LandryEllis/ENCE_3231/2WheelBotFinal5-5/components/ESP8266-01_ESP-01/step/ESP8266-01_ESP-01.step

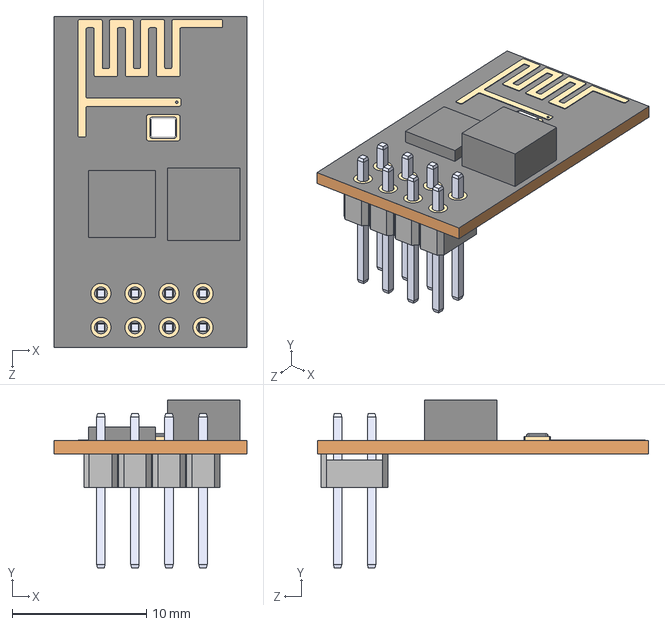
[picture p12: CAD file, 2026-04-23]
2WheelBotFinal5-5/components/ESP8266-01_ESP-01/step/ESP8266-01_ESP-01.step
14.4 x 12.5 x 24.7 mm
