LandryEllis/ENCE_3231/2WheelBotFinal5-5/components/Fuse_3DModel/MF-MSMF050-2--3DModel-STEP-56544.STEP

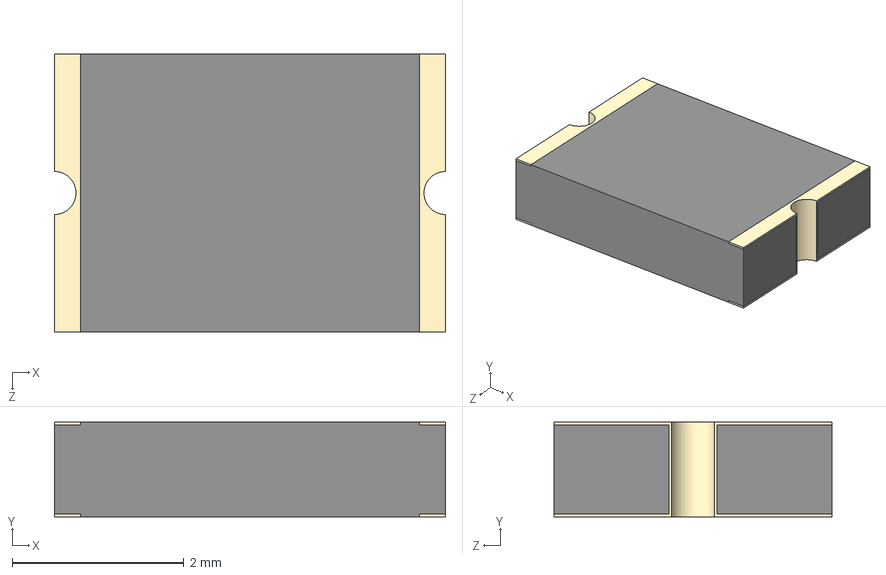
[picture p13: CAD file, 2026-04-23]
2WheelBotFinal5-5/components/Fuse_3DModel/MF-MSMF050-2--3DModel-STEP-56544.STEP
4.55 x 1.10 x 3.24 mm
