LandryEllis/ENCE_3231/2WheelBotFinal5-5/components/MPU6050/ITG-MPU.STEP

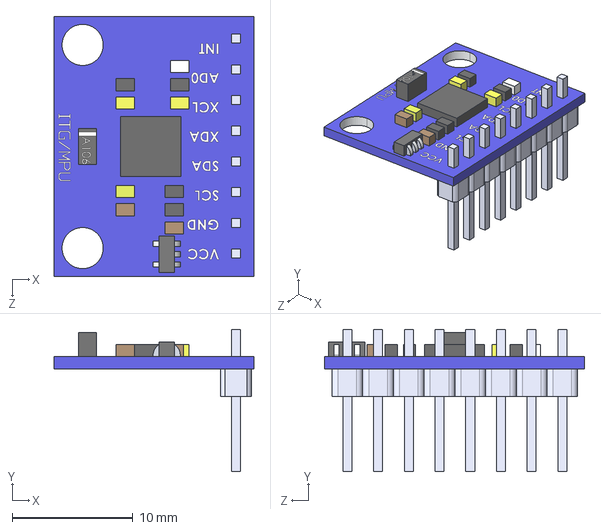
[picture p14: CAD file, 2026-04-23]
2WheelBotFinal5-5/components/MPU6050/ITG-MPU.STEP
16.5 x 11.8 x 21.5 mm
8 Header-Pin
Placa_Base
