LandryEllis/ENCE_3231/2WheelBotFinal5-5/components/SPDT_Slide_Switch/step/SLW-66527511-SMT-TR.step

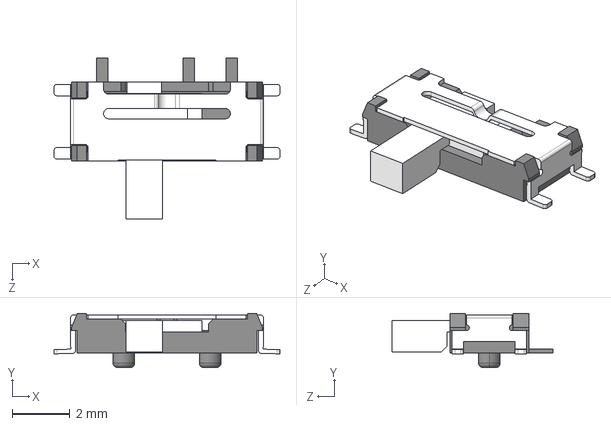
[picture p15: CAD file, 2026-04-23]
2WheelBotFinal5-5/components/SPDT_Slide_Switch/step/SLW-66527511-SMT-TR.step
7.86 x 1.88 x 5.58 mm
