LandryEllis/ENCE_3231/2WheelBotFinal5-5/components/SW_uP_Reset/step/SW_uP_Reset.stp

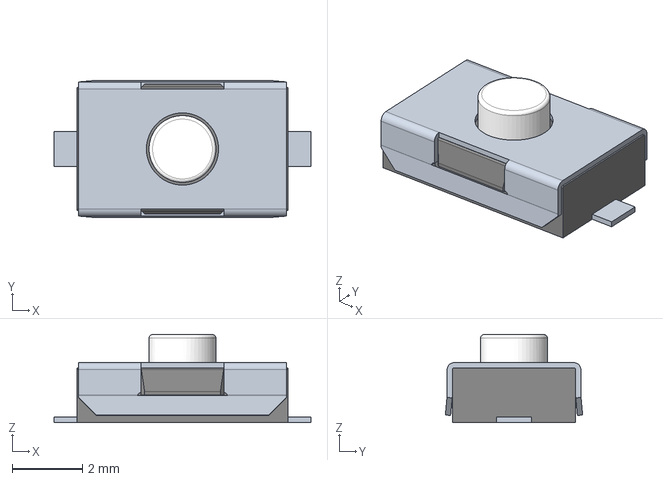
[picture p16: CAD file, 2026-04-23]
2WheelBotFinal5-5/components/SW_uP_Reset/step/SW_uP_Reset.stp
7.30 x 3.90 x 2.50 mm
