LandryEllis/ENCE_3231/2WheelBotFinal5-5/components/USB4105GFA--3DModel-STEP-510211.STEP

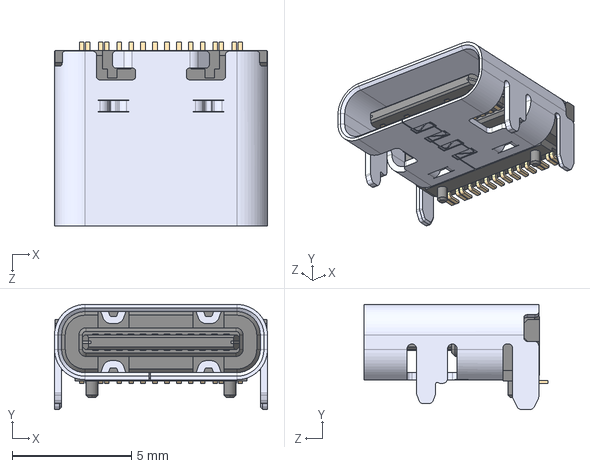
[picture p17: CAD file, 2026-04-30]
2WheelBotFinal5-5/components/USB4105GFA--3DModel-STEP-510211.STEP
8.94 x 4.41 x 7.71 mm
