LandryEllis/ENCE_3231/2WheelBotFinal5-5/4-21 kicad of inverted pendalum.kicad_pcb

## KiCad design 2WheelBotFinal5-5/4-21 kicad of inverted pendalum.kicad_pcb (2026-05-05)

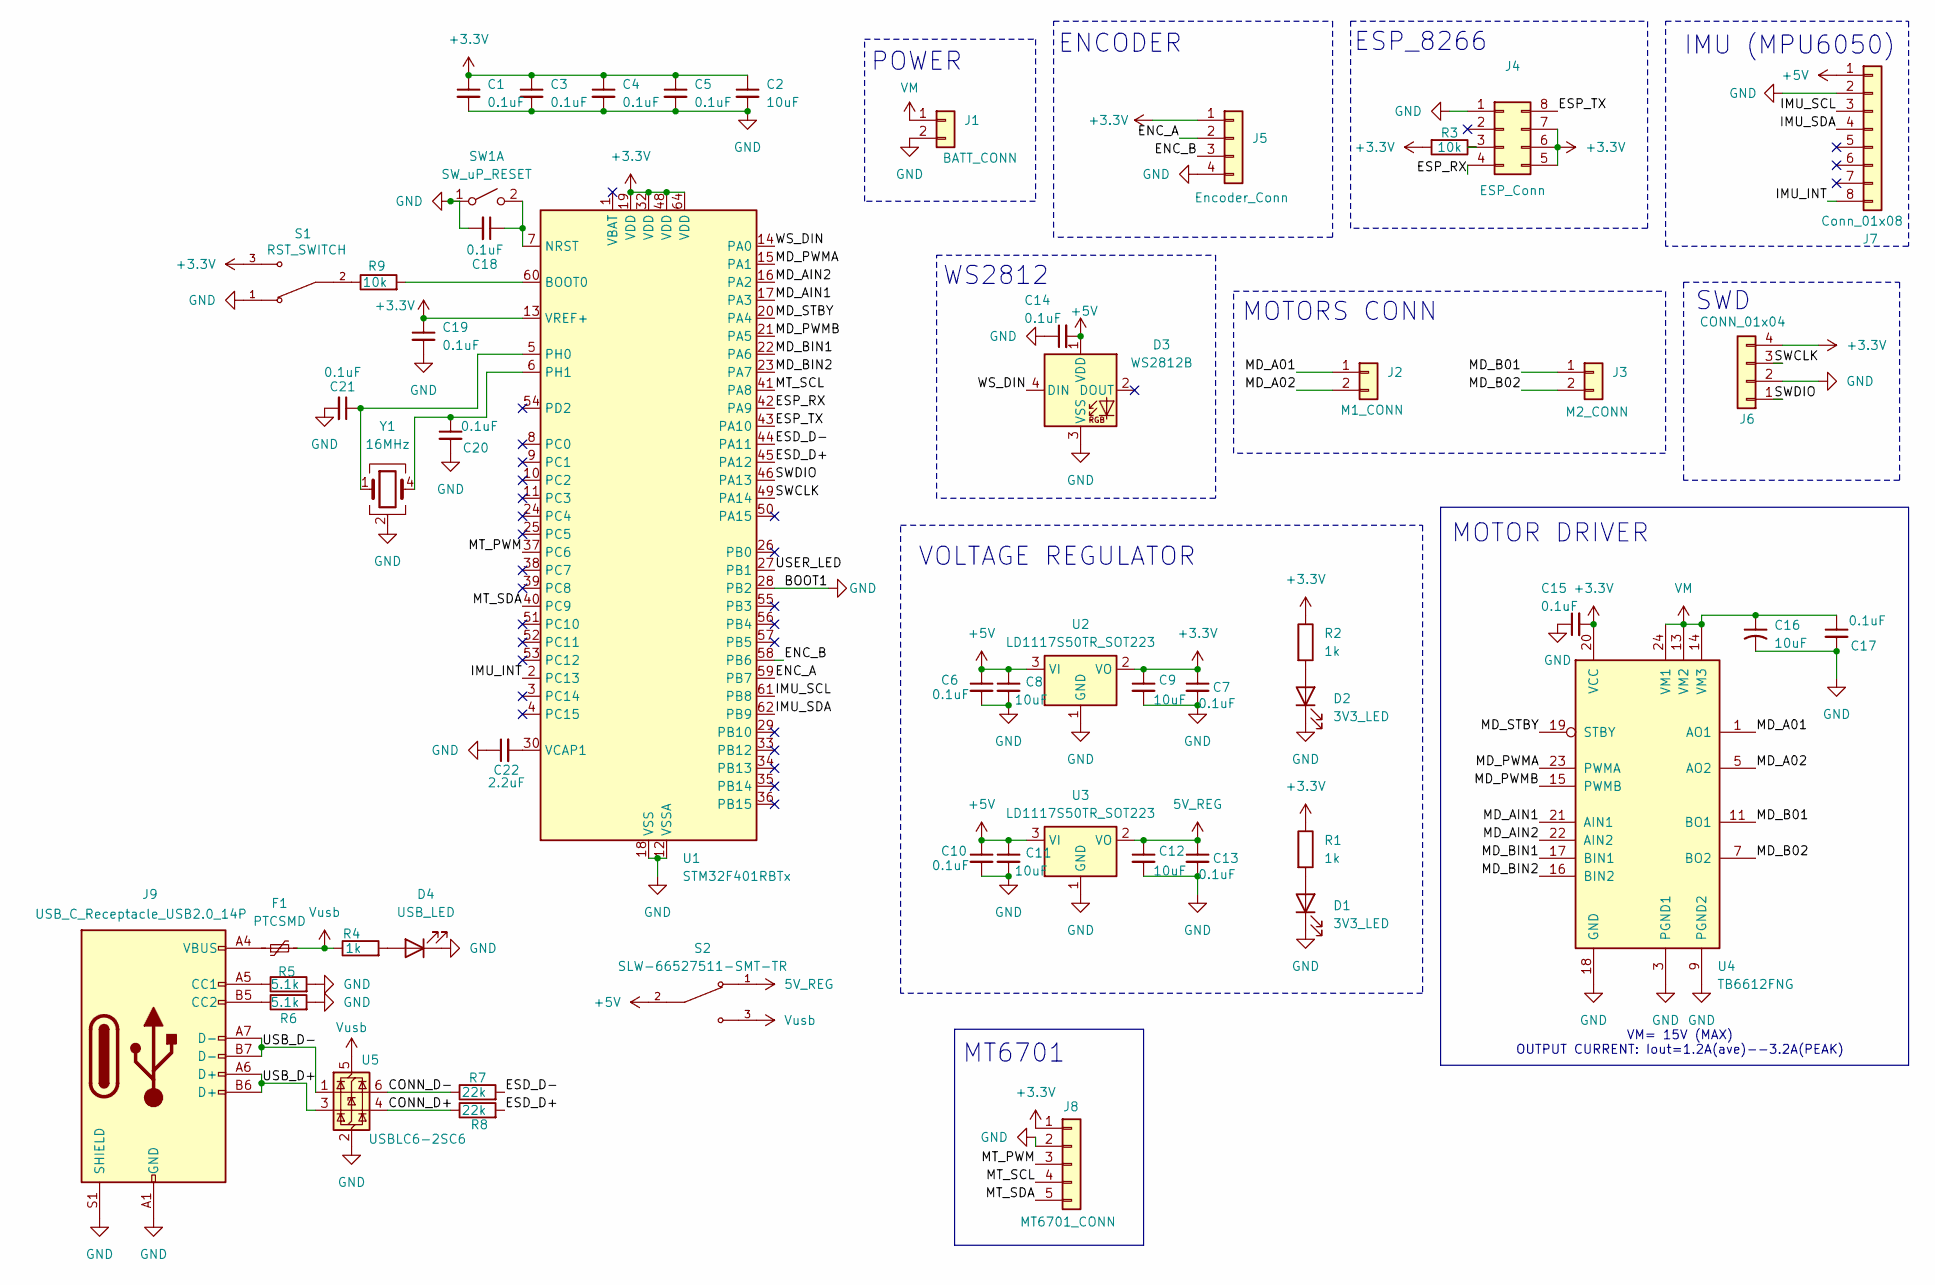
[picture p19: schematic 4-21 kicad of inverted pendalum.kicad_sch, 2Wheel Robot]

Parts:
C1, C3, C4, C5, C6, C7, C10, C13, C14, C15, C17, C18, C19, C20, C21: 0.1uF; C_0805_2012Metric_Pad1.18x1.45mm_HandSolder; mfr. # KYOCERA AVX
C2, C8, C9, C11, C12: 10uF; C_0805_2012Metric_Pad1.18x1.45mm_HandSolder; Mouser # 963-MCASL21GBB7106KT
C16: 10uF; C_0805_2012Metric_Pad1.18x1.45mm_HandSolder
C22: 2.2uF; C_0805_2012Metric_Pad1.18x1.45mm_HandSolder
D1, D2: 3V3_LED; LED_0805_2012Metric_Pad1.15x1.40mm_HandSolder
D3: WS2812B; LED_WS2812B_PLCC4_5.0x5.0mm_P3.2mm
D4: USB_LED; LED_0805_2012Metric_Pad1.15x1.40mm_HandSolder
F1: PTCSMD; Fuse_1812_4532Metric
J1: BATT_CONN; JST_XH_B2B-XH-A_1x02_P2.50mm_Vertical
J2: M1_CONN; JST_XH_B2B-XH-A_1x02_P2.50mm_Vertical
J3: M2_CONN; JST_XH_B2B-XH-A_1x02_P2.50mm_Vertical
J4: ESP_Conn; PinSocket_2x04_P2.54mm_Vertical
J5: Encoder_Conn; JST_XH_B4B-XH-A_1x04_P2.50mm_Vertical
J6: CONN_01x04; PinHeader_1x04_P2.54mm_Vertical
J7: Conn_01x08; PinSocket_1x08_P2.54mm_Vertical
J8: MT6701_CONN; JST_XH_B5B-XH-A_1x05_P2.50mm_Vertical
J9: USB_C_Receptacle_USB2.0_14P; USB_C_Receptacle_HCTL_HC-TYPE-C-16P-01A
R1, R2, R4: 1k; R_0805_2012Metric_Pad1.20x1.40mm_HandSolder
R3, R9: 10k; R_0805_2012Metric_Pad1.20x1.40mm_HandSolder
R5, R6: 5.1k; R_0805_2012Metric_Pad1.20x1.40mm_HandSolder
R7, R8: 22k; R_0805_2012Metric_Pad1.20x1.40mm_HandSolder
S1: RST_SWITCH; SW_SLW-66527511-SMT-TR; PARTREV 1.01
S2: SLW-66527511-SMT-TR; SW_SLW-66527511-SMT-TR; PARTREV 1.01
SW1: SW_uP_RESET; SW_uP_Reset
U1: STM32F401RBTx; LQFP-64_10x10mm_P0.5mm; Mfr. # STM32F401RET6
U2, U3: LD1117S50TR_SOT223; SOT-223-3_TabPin2; Mouser # 511-LD1117S50
U4: TB6612FNG; SSOP-24_5.3x8.2mm_P0.65mm
U5: USBLC6-2SC6; SOT-23-6
Y1: 16MHz; Crystal_SMD_Abracon_ABM8G-4Pin_3.2x2.5mm

Connections:
5V_REG: C12.1, C13.1, S2.1, U3.2 (VO)
+3.3V: C1.1, C2.1, C3.1, C4.1, C5.1, C7.1, C9.1, C15.2, C19.1, J4.5, J4.6, J4.7, J5.1, J6.4, J8.1, R1.1, R2.1, R3.2, S1.3, U1.13 (VREF+), U1.19 (VDD), U1.32 (VDD), U1.48 (VDD), U1.64 (VDD), U2.2 (VO), U4.20 (VCC)
+5V: C6.1, C8.1, C10.1, C11.1, C14.2, D3.1 (VDD), J7.1, S2.2, U2.3 (VI), U3.3 (VI)
/CONN_D+: R8.1, U5.4 (I/O2)
/CONN_D-: R7.1, U5.6 (I/O1)
/ENC_A: J5.2, U1.59 (PB7)
/ENC_B: J5.3, U1.58 (PB6)
/ESD_D+: R8.2, U1.45 (PA12)
/ESD_D-: R7.2, U1.44 (PA11)
/ESP_RX: J4.4, U1.42 (PA9)
/ESP_TX: J4.8, U1.43 (PA10)
/IMU_INT: J7.8, U1.2 (PC13)
/IMU_SCL: J7.3, U1.61 (PB8)
/IMU_SDA: J7.4, U1.62 (PB9)
/MD_A01: J2.1, U4.1 (AO1), U4.2 (AO1)
/MD_A02: J2.2, U4.5 (AO2), U4.6 (AO2)
/MD_AIN1: U1.17 (PA3), U4.21 (AIN1)
/MD_AIN2: U1.16 (PA2), U4.22 (AIN2)
/MD_B01: J3.1, U4.11 (BO1), U4.12 (BO1)
/MD_B02: J3.2, U4.7 (BO2), U4.8 (BO2)
/MD_BIN1: U1.22 (PA6), U4.17 (BIN1)
/MD_BIN2: U1.23 (PA7), U4.16 (BIN2)
/MD_PWMA: U1.15 (PA1), U4.23 (PWMA)
/MD_PWMB: U1.21 (PA5), U4.15 (PWMB)
/MD_STBY: U1.20 (PA4), U4.19 (STBY)
/MT_PWM: J8.3, U1.37 (PC6)
/MT_SCL: J8.4, U1.41 (PA8)
/MT_SDA: J8.5, U1.40 (PC9)
/SWCLK: J6.3, U1.49 (PA14)
/SWDIO: J6.1, U1.46 (PA13)
/USB_D+: J9.A6 (D+), J9.B6 (D+), U5.3 (I/O2)
/USB_D-: J9.A7 (D-), J9.B7 (D-), U5.1 (I/O1)
/USER_LED: U1.27 (PB1)
/WS_DIN: D3.4 (DIN), U1.14 (PA0)
GND: C1.2, C2.2, C3.2, C4.2, C5.2, C6.2, C7.2, C8.2, C9.2, C10.2, C11.2, C12.2, C13.2, C14.1, C15.1, C16.2, C17.2, C18.2, C19.2, C20.2, C21.2, C22.1, D1.1 (K), D2.1 (K), D3.3 (VSS), D4.1 (K), J1.2, J4.1, J5.4, J6.2, J7.2, J8.2, J9.A1 (GND), J9.A12 (GND), J9.B1 (GND), J9.B12 (GND), J9.S1 (SHIELD), R5.2, R6.2, S1.1, SW1.1 (A), U1.12 (VSSA), U1.18 (VSS), U1.28 (PB2), U1.31 (VSS), U1.47 (VSS), U1.63 (VSS), U2.1 (GND), U3.1 (GND), U4.3 (PGND1), U4.4 (PGND1), U4.9 (PGND2), U4.10 (PGND2), U4.18 (GND), U5.2 (GND), Y1.2 (G), Y1.3 (G)
unnamed: D1.2 (A), R1.2
unnamed: D2.2 (A), R2.2
unnamed: D4.2 (A), R4.2
unnamed: F1.1, J9.A4 (VBUS), J9.A9 (VBUS), J9.B4 (VBUS), J9.B9 (VBUS)
unnamed: J4.3, R3.1
unnamed: J9.A5 (CC1), R5.1
unnamed: J9.B5 (CC2), R6.1
unnamed: R9.1, S1.2
unnamed: C18.1, SW1.2 (B), U1.7 (NRST)
unnamed: R9.2, U1.60 (BOOT0)
unnamed: C21.1, U1.5 (PH0), Y1.1
unnamed: C20.1, U1.6 (PH1), Y1.4
unnamed: C22.2, U1.30 (VCAP1)
VM: C16.1, C17.1, J1.1, U4.13 (VM2), U4.14 (VM3), U4.24 (VM1)
Vusb: F1.2, R4.1, S2.3, U5.5 (VBUS)

Notes on the sheet:
VM= 15V (MAX) OUTPUT CURRENT: Iout=1.2A(ave)--3.2A(PEAK)
ESP_8266
IMU (MPU6050)
MT6701
SWD
MOTORS CONN
POWER
ENCODER
WS2812
VOLTAGE REGULATOR
MOTOR DRIVER

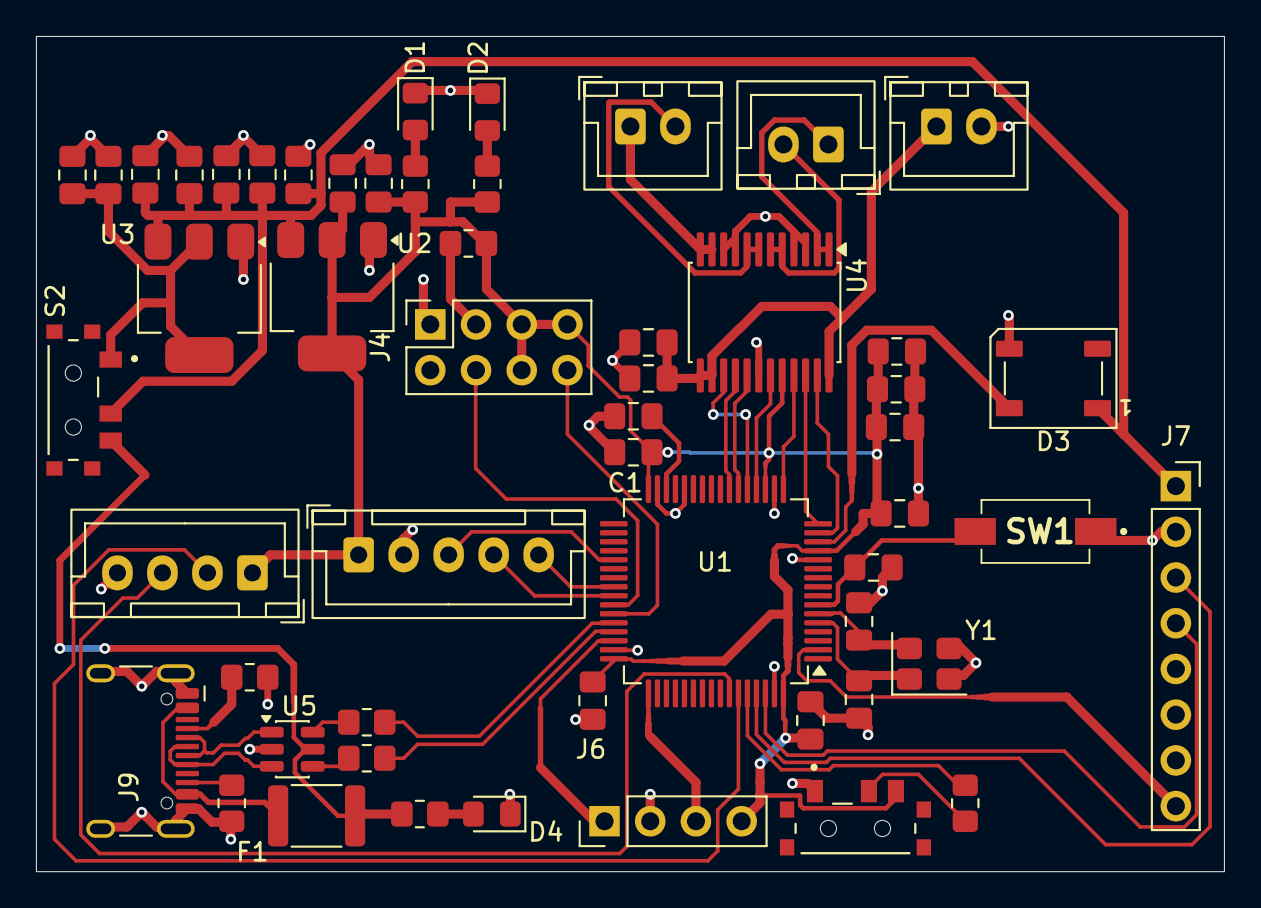
[picture p20: board 4-21 kicad of inverted pendalum.kicad_pcb from above]

Board: 2 copper layers, 66.0 x 46.4 mm, 54 parts (0 on the bottom side), 49 nets.
